TigranDesigner/Voron-Mods/DooMini/Photos/DooMini (6).jpg

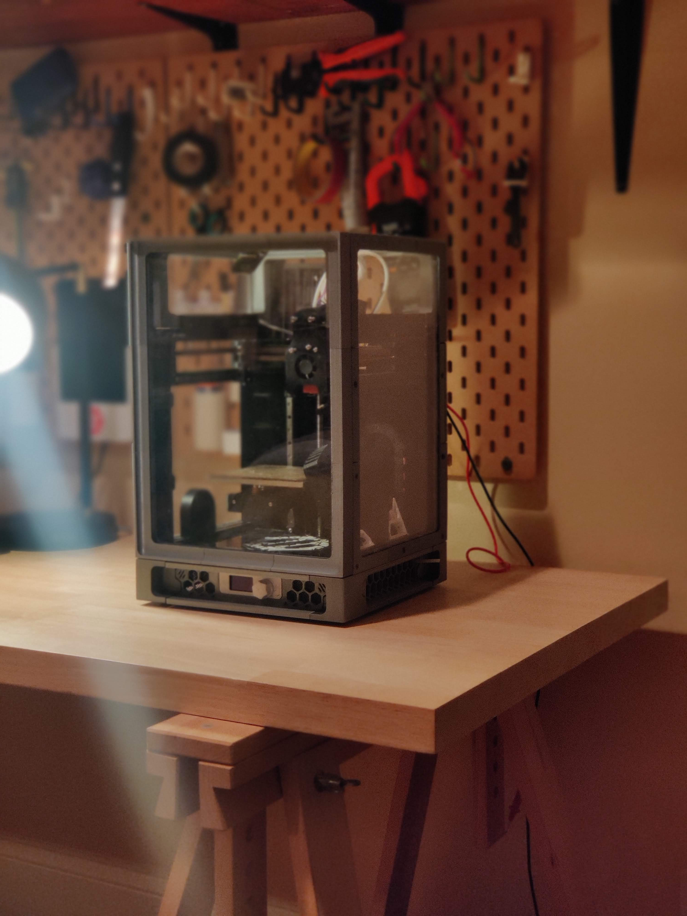
DooMini/Photos/DooMini (6).jpg
