TigranDesigner/Voron-Mods/DooMini/Photos/DooMini (1).jpg

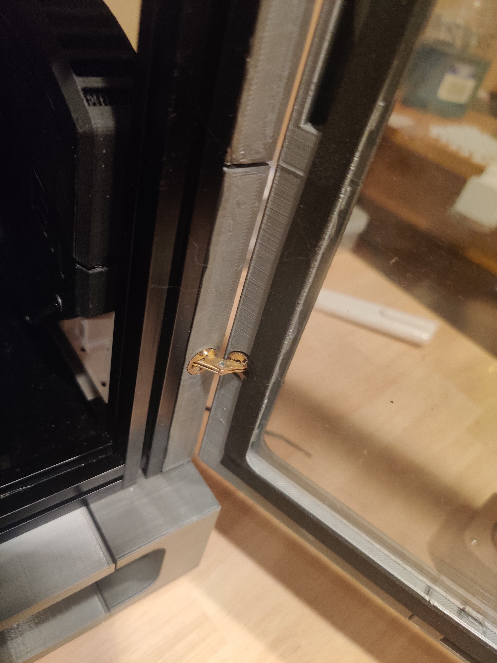
DooMini/Photos/DooMini (1).jpg
