TigranDesigner/Voron-Mods/README.md

# Voron-Mods
Voron 3D printer mods, remixes and designs. 
 
DooMini is here !!!
