TigranDesigner/Voron-Mods/DooMini Folding Spool Holder/README.md

<h1 align="center">Foldable Spool Honder For DooMini</h1>

  <p align="center">
    
| BOM  |       
| ------------- |
| 1x Heat set insert |
| 1x 16mm M3 flat head screw|
| 2x PTFE tube 85mm |
| 3D printed parts |
  
</p>

ViewCapture20220612_001325

ViewCapture20220612_001409
