TigranDesigner/Voron-Mods/DooMini Folding Spool Holder/Images/unknown (1).png

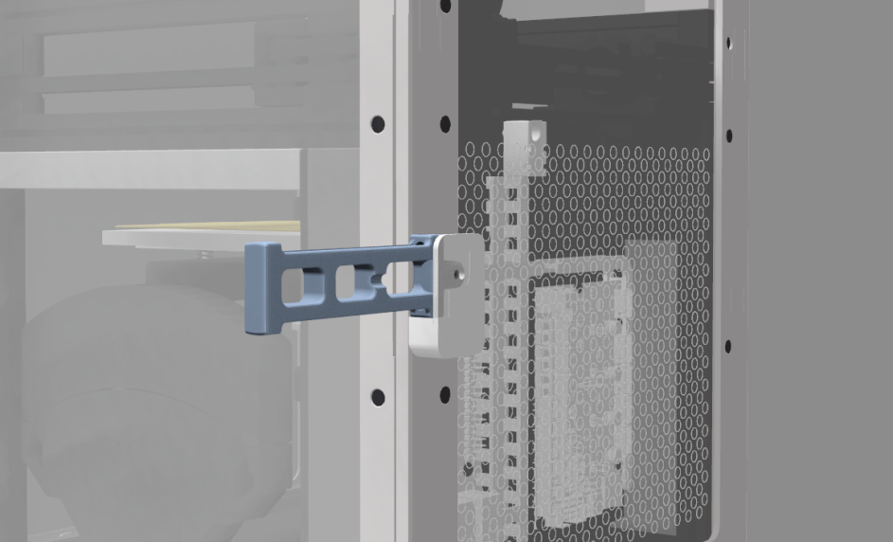
DooMini Folding Spool Holder/Images/unknown (1).png
