TigranDesigner/Voron-Mods/DooMini Folding Spool Holder/Images/unknown.png

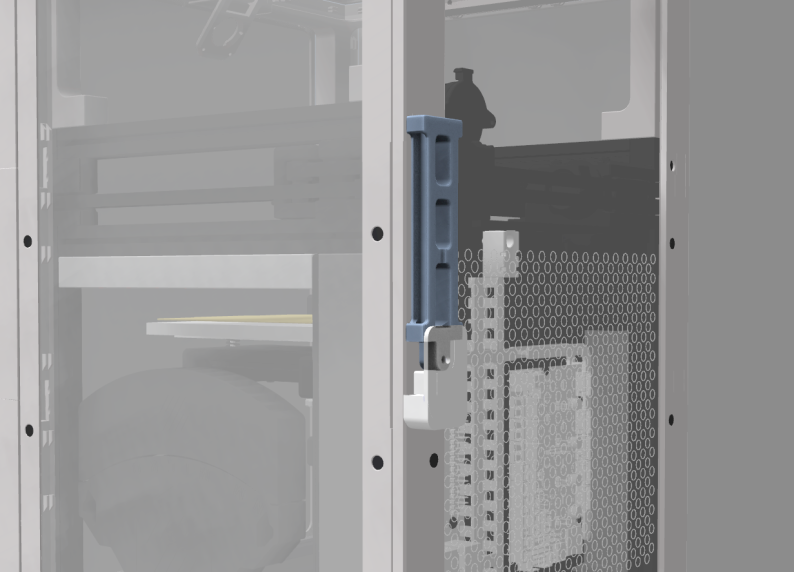
DooMini Folding Spool Holder/Images/unknown.png
