TigranDesigner/Voron-Mods/DooMini Folding Spool Holder/Images/ViewCapture20220612_001409.jpg

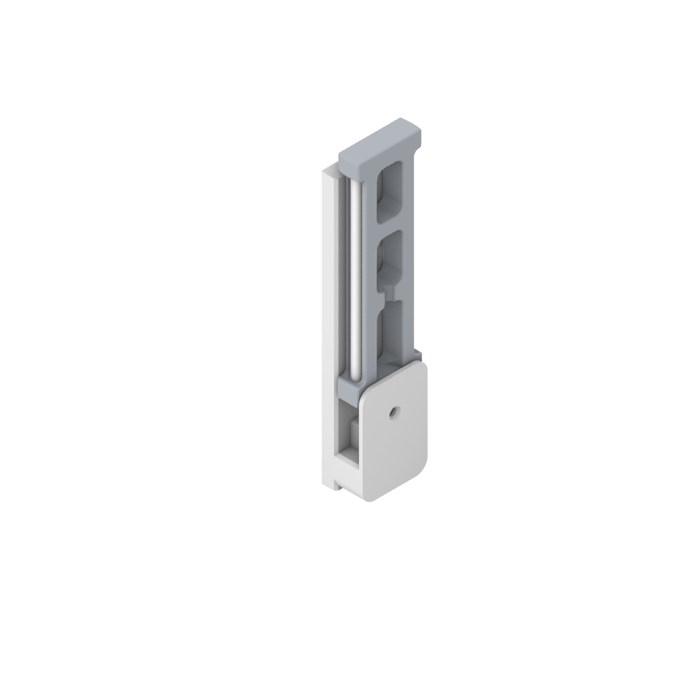
DooMini Folding Spool Holder/Images/ViewCapture20220612_001409.jpg
