TigranDesigner/Voron-Mods/DooMini/Photos/DooMini (5).jpg

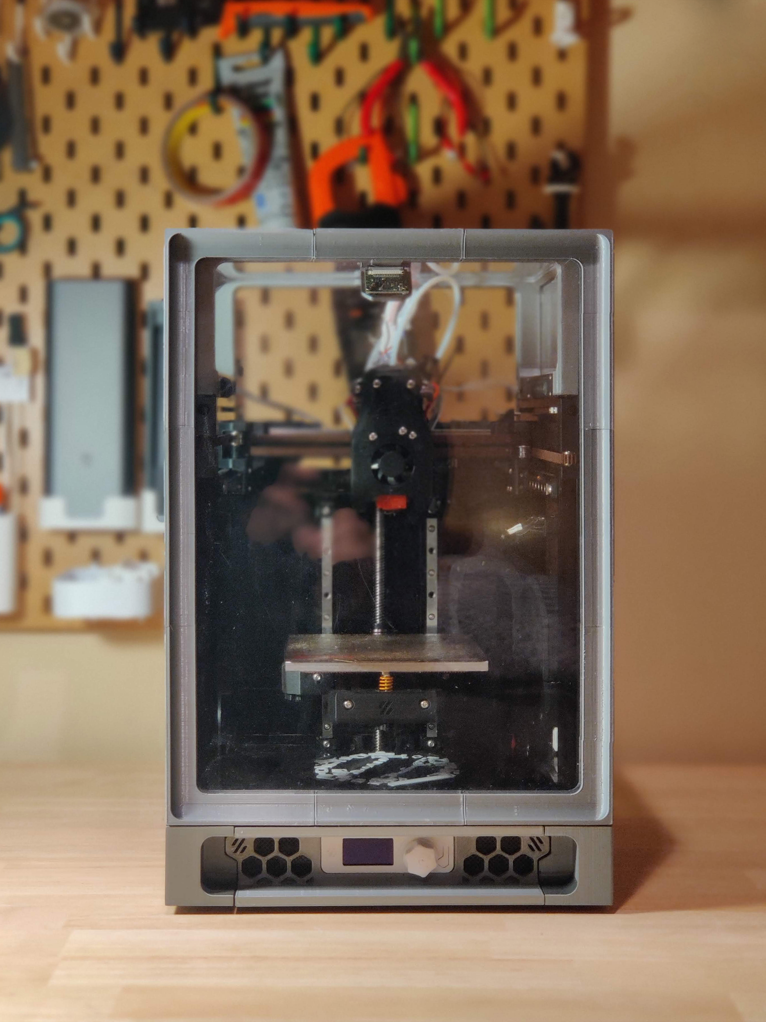
DooMini/Photos/DooMini (5).jpg
