TigranDesigner/Voron-Mods/DooMini/Photos/DooMini (7).jpg

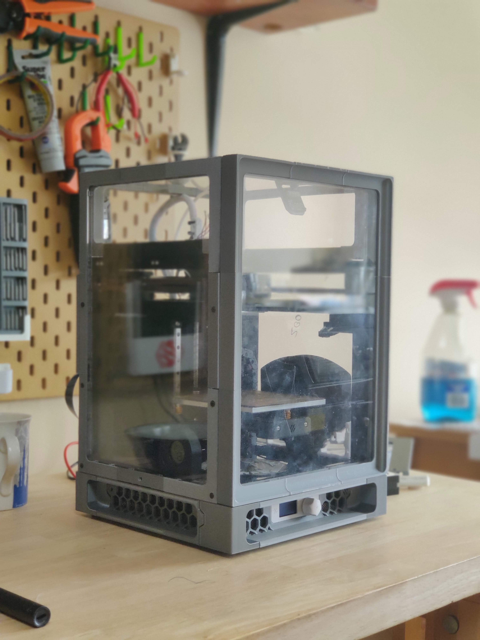
DooMini/Photos/DooMini (7).jpg
