TigranDesigner/Voron-Mods/DooMini Folding Spool Holder/STL/Hinge.stl

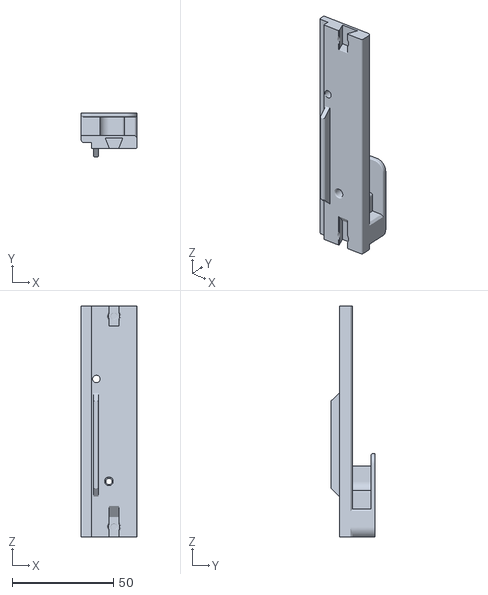
[picture p9: CAD file, 2022-06-12]
DooMini Folding Spool Holder/STL/Hinge.stl
27.5 x 21.9 x 114.3
