TigranDesigner/Voron-Mods/DooMini/DXFs/1X Back Panel Beta 2.dxf

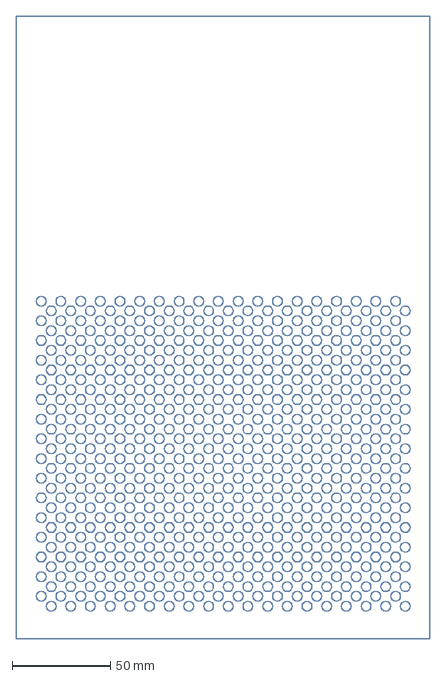
[picture p10: CAD file, 2022-03-14]
DooMini/DXFs/1X Back Panel Beta 2.dxf
210.0 x 316.0 mm
