TigranDesigner/Voron-Mods/DooMini/STLs/3D printed Interlock X28 Beta1.stl

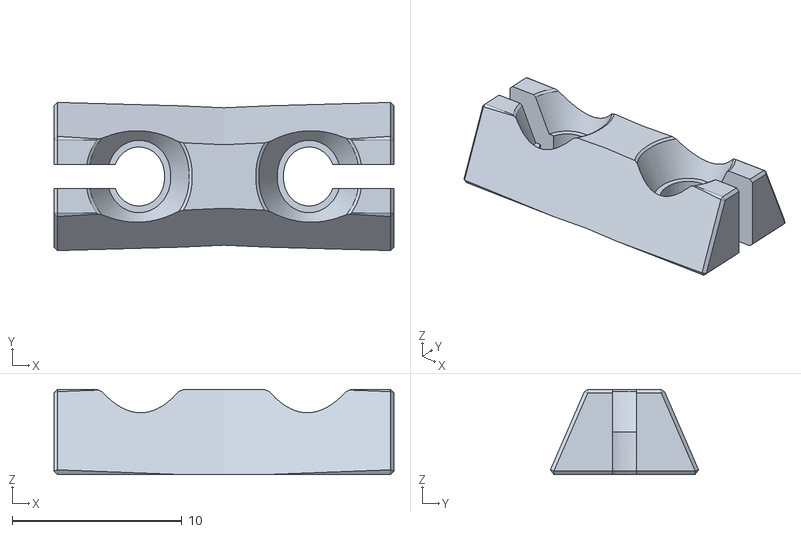
[picture p11: CAD file, 2022-02-13]
DooMini/STLs/3D printed Interlock X28 Beta1.stl
20.0 x 8.72 x 5.00
