TigranDesigner/Voron-Mods/DooMini/STLs/Back/Back H Beta1.stl

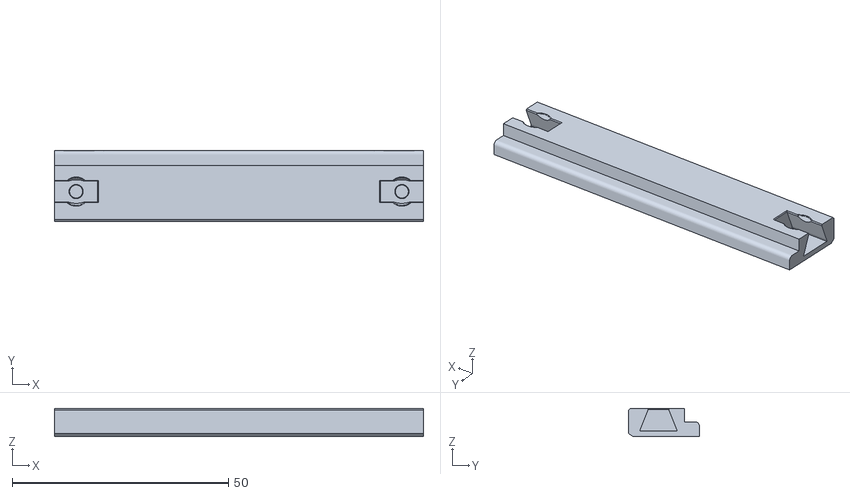
[picture p12: CAD file, 2022-02-14]
DooMini/STLs/Back/Back H Beta1.stl
85.3 x 16.4 x 6.50
