TigranDesigner/Voron-Mods/DooMini/STLs/Base/Base Panel Left Beta2.stl

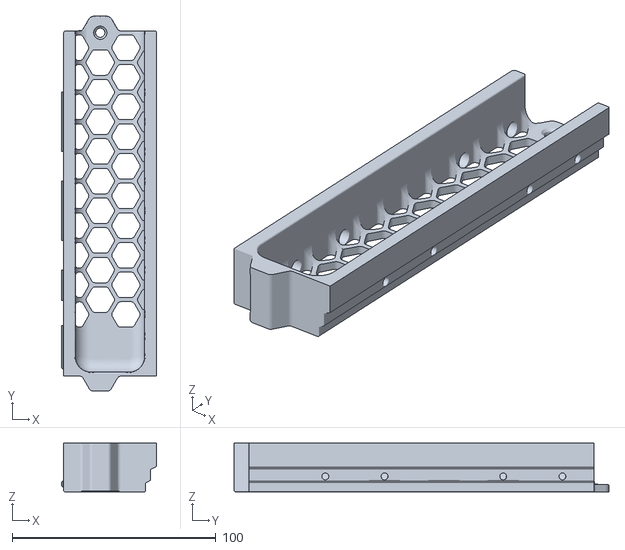
[picture p13: CAD file, 2022-06-12]
DooMini/STLs/Base/Base Panel Left Beta2.stl
46.5 x 183.9 x 23.8
