TigranDesigner/Voron-Mods/DooMini/STLs/Door/Door H Beta2.stl

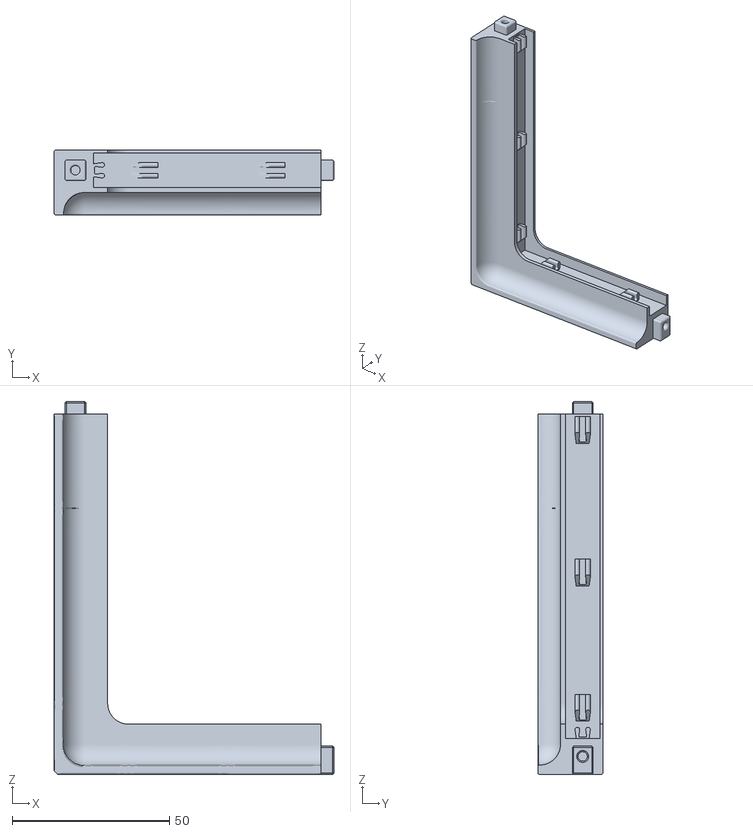
[picture p14: CAD file, 2022-08-16]
DooMini/STLs/Door/Door H Beta2.stl
88.8 x 20.8 x 118.5
