TigranDesigner/Voron-Mods/DooMini/STLs/Left/Left C Beta 2.stl

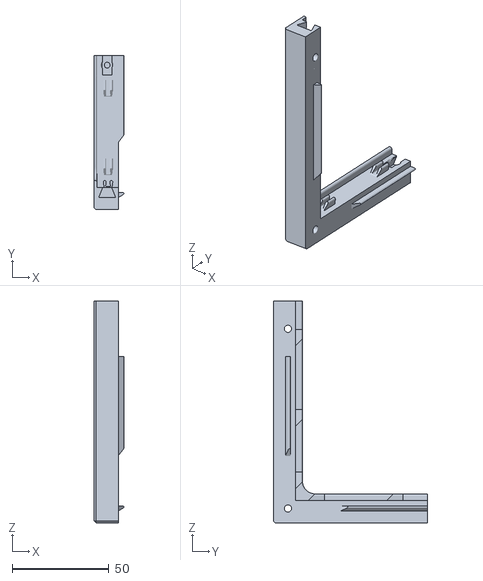
[picture p15: CAD file, 2022-03-18]
DooMini/STLs/Left/Left C Beta 2.stl
15.4 x 79.5 x 114.5
