TigranDesigner/Voron-Mods/DooMini/STLs/Top/Top G X2 Beta1.stl

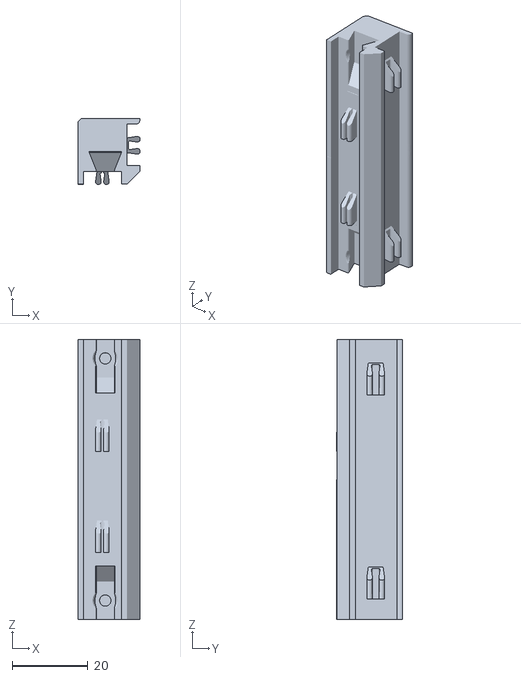
[picture p16: CAD file, 2022-02-14]
DooMini/STLs/Top/Top G X2 Beta1.stl
16.5 x 17.5 x 74.0
