TigranDesigner/Voron-Mods/DooMini/DXFs/4X Side Pane Beta1l.dxf

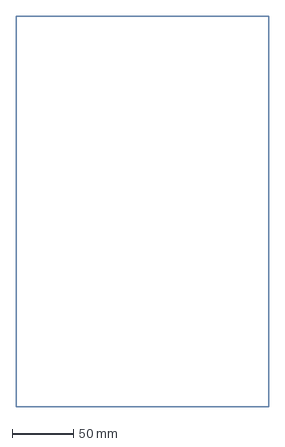
[picture p17: CAD file, 2022-02-14]
DooMini/DXFs/4X Side Pane Beta1l.dxf
206.0 x 318.0 mm
