TigranDesigner/Voron-Mods/DooMini/STLs/Back/Back G Beta1.stl

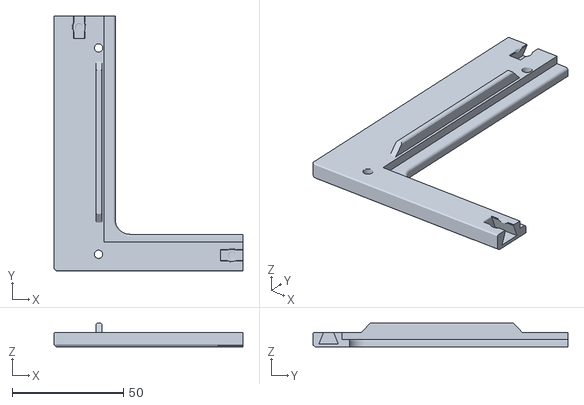
[picture p18: CAD file, 2022-02-14]
DooMini/STLs/Back/Back G Beta1.stl
84.8 x 114.5 x 10.7
