TigranDesigner/Voron-Mods/DooMini/STLs/Door/Door A Beta1.stl

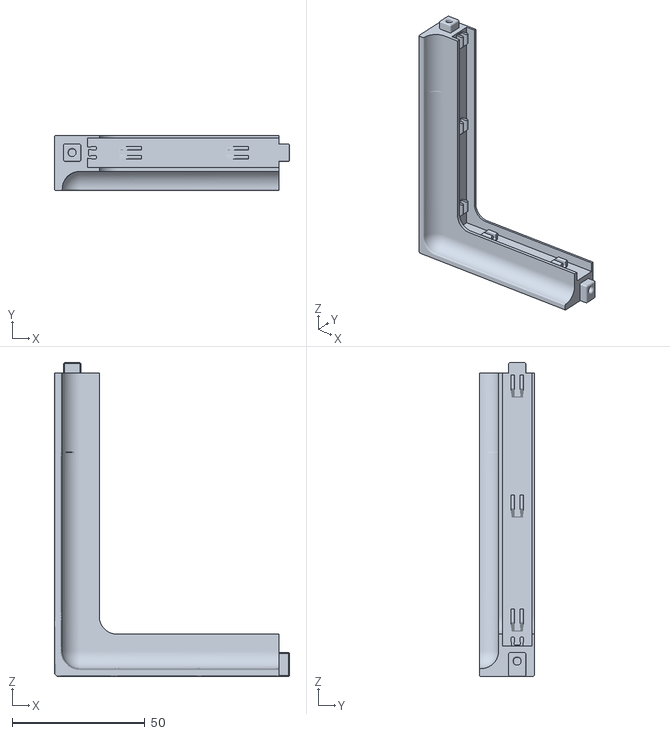
[picture p19: CAD file, 2022-04-15]
DooMini/STLs/Door/Door A Beta1.stl
88.8 x 20.8 x 118.5
