TigranDesigner/Voron-Mods/DooMini/STLs/Left/Left D Beta 2.stl

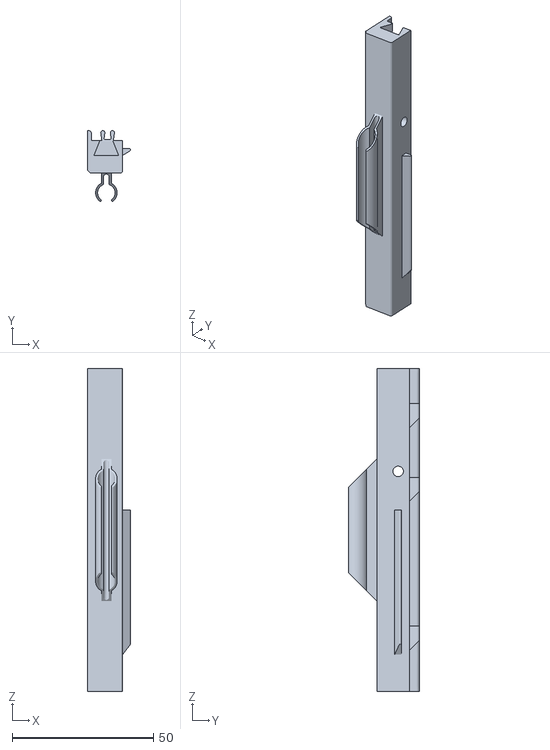
[picture p20: CAD file, 2022-03-18]
DooMini/STLs/Left/Left D Beta 2.stl
15.4 x 25.0 x 114.3
