TigranDesigner/Voron-Mods/DooMini/STLs/Right/Right E Beta 2.stl

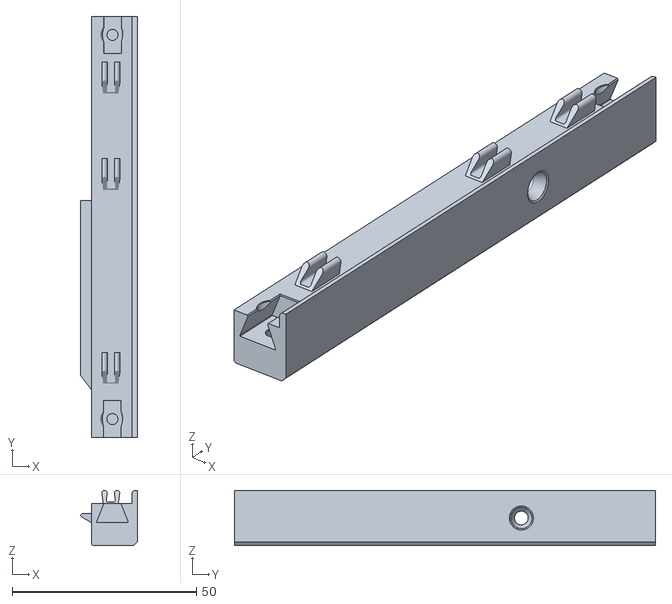
[picture p21: CAD file, 2022-03-18]
DooMini/STLs/Right/Right E Beta 2.stl
15.4 x 114.3 x 15.0
