TigranDesigner/Voron-Mods/DooMini/DXFs/2X Top Panel Beta1.dxf

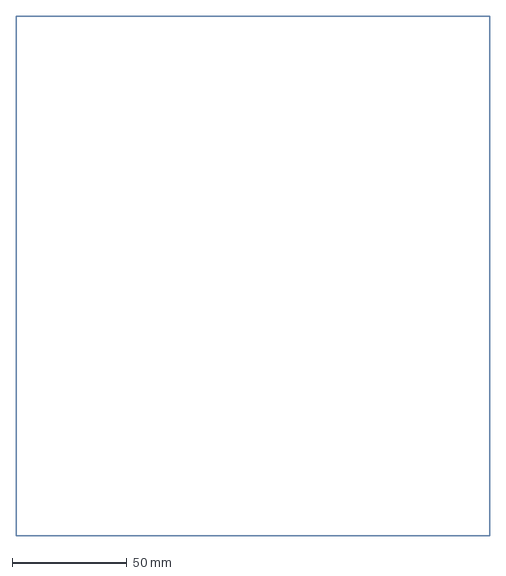
[picture p23: CAD file, 2022-02-14]
DooMini/DXFs/2X Top Panel Beta1.dxf
206.0 x 226.0 mm
