TigranDesigner/Voron-Mods/DooMini/STLs/Back/Back F Beta1.stl

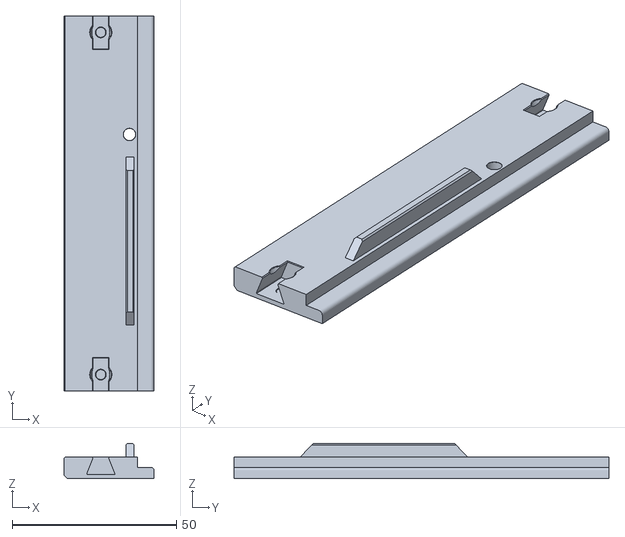
[picture p24: CAD file, 2022-02-14]
DooMini/STLs/Back/Back F Beta1.stl
27.5 x 114.3 x 10.7
