TigranDesigner/Voron-Mods/DooMini/STLs/Base/Base Panel Front Beta2.stl

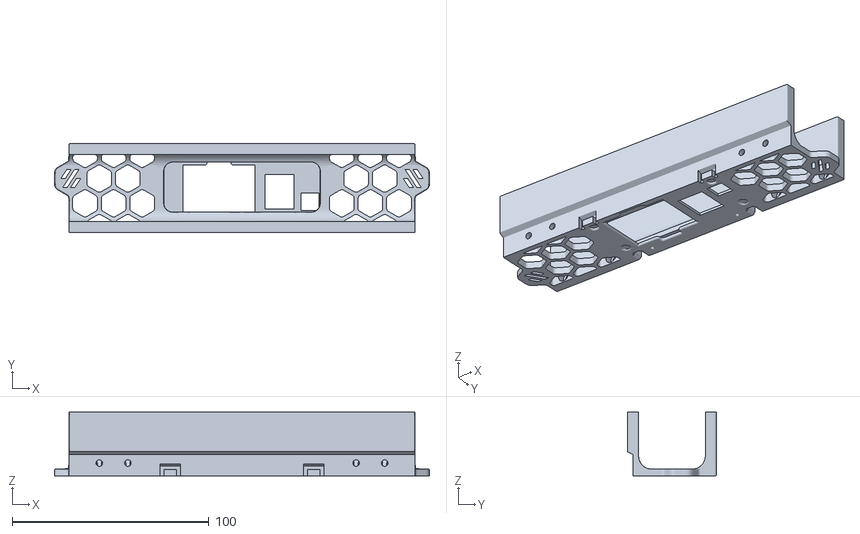
[picture p25: CAD file, 2022-06-10]
DooMini/STLs/Base/Base Panel Front Beta2.stl
190.8 x 45.5 x 32.5
