TigranDesigner/Voron-Mods/DooMini/STLs/Right/Right D Beta1.stl

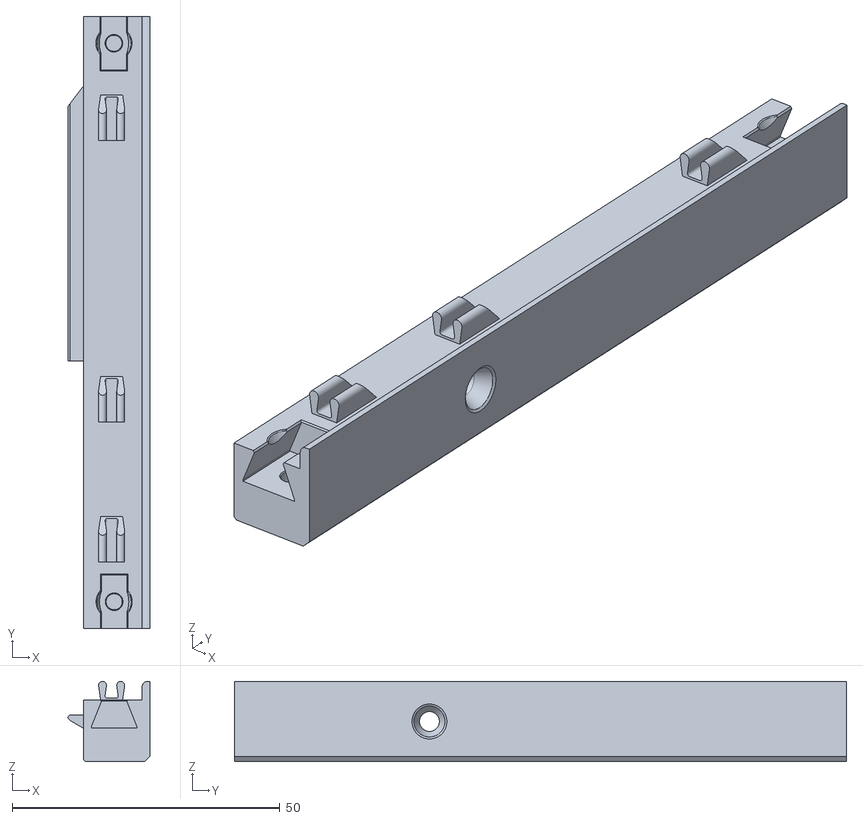
[picture p26: CAD file, 2022-02-14]
DooMini/STLs/Right/Right D Beta1.stl
15.4 x 114.3 x 15.0
