TigranDesigner/Voron-Mods/DooMini/DXFs/2X Door Panel Beta1.dxf

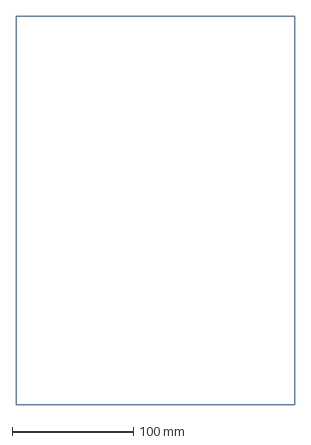
[picture p28: CAD file, 2022-02-14]
DooMini/DXFs/2X Door Panel Beta1.dxf
229.0 x 320.0 mm
