TigranDesigner/Voron-Mods/DooMini/STLs/Back/Back E Beta1.stl

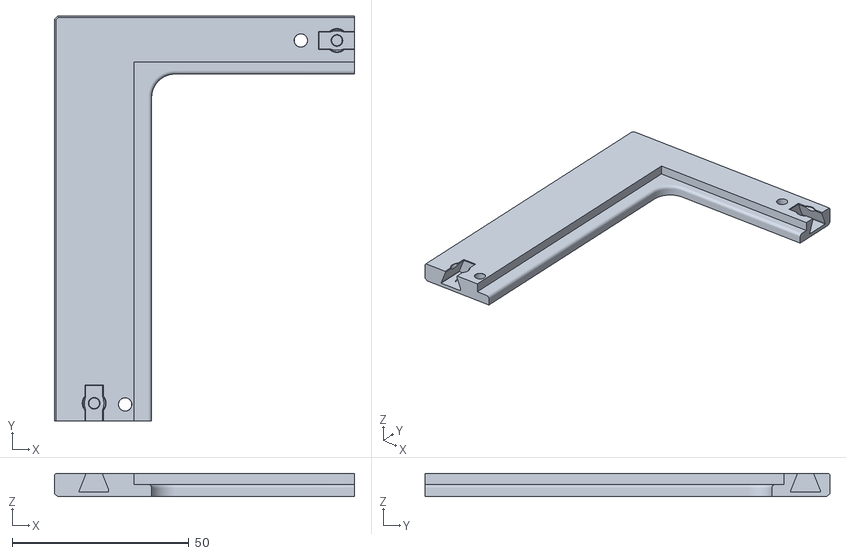
[picture p29: CAD file, 2022-02-14]
DooMini/STLs/Back/Back E Beta1.stl
84.8 x 114.4 x 6.50
