TigranDesigner/Voron-Mods/DooMini/STLs/Base/Base Panel Back Beta 4.stl

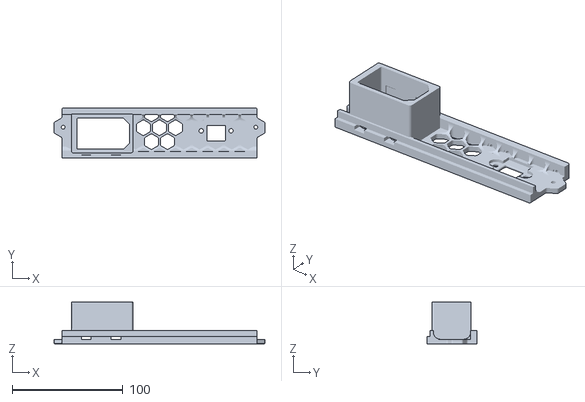
[picture p30: CAD file, 2022-03-06]
DooMini/STLs/Base/Base Panel Back Beta 4.stl
190.9 x 45.5 x 37.9
