TigranDesigner/Voron-Mods/DooMini/STLs/Door/Door G Beta1.stl

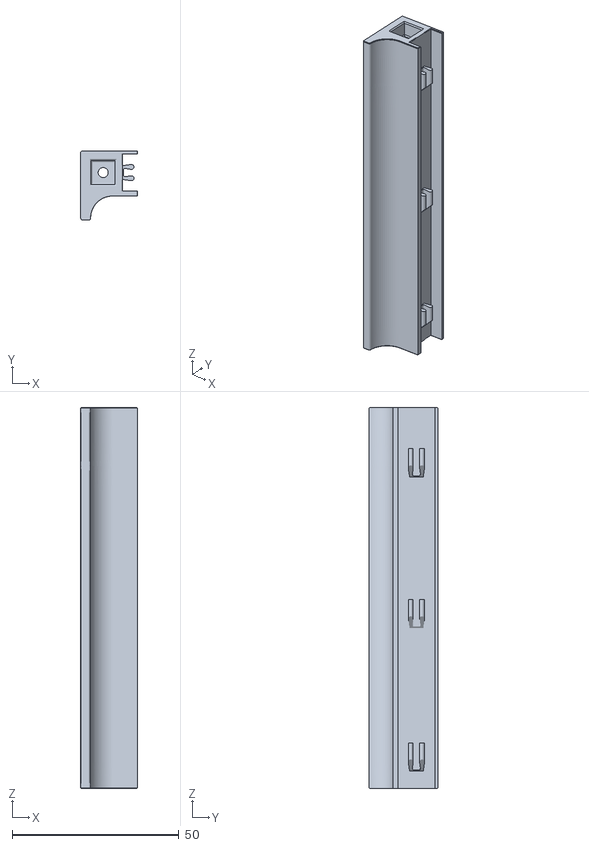
[picture p31: CAD file, 2022-02-14]
DooMini/STLs/Door/Door G Beta1.stl
17.0 x 20.8 x 114.3
