TigranDesigner/Voron-Mods/DooMini/STLs/Left/Left B Beta1.stl

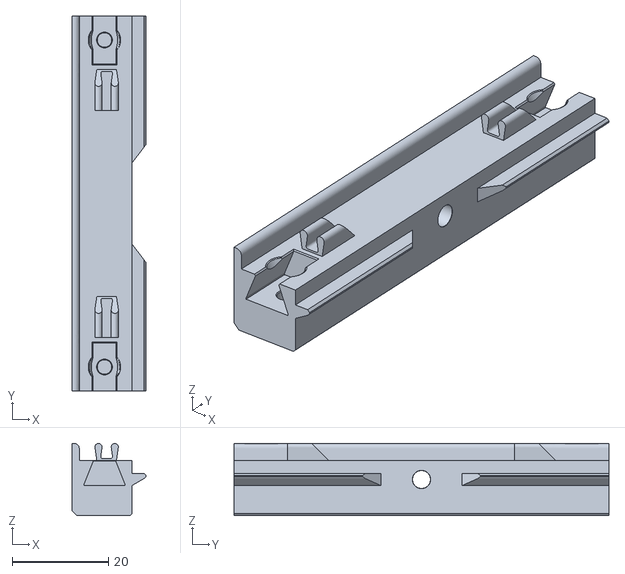
[picture p32: CAD file, 2022-02-14]
DooMini/STLs/Left/Left B Beta1.stl
15.4 x 78.1 x 15.0
