TigranDesigner/Voron-Mods/DooMini/STLs/Top/Top D Beta1.stl

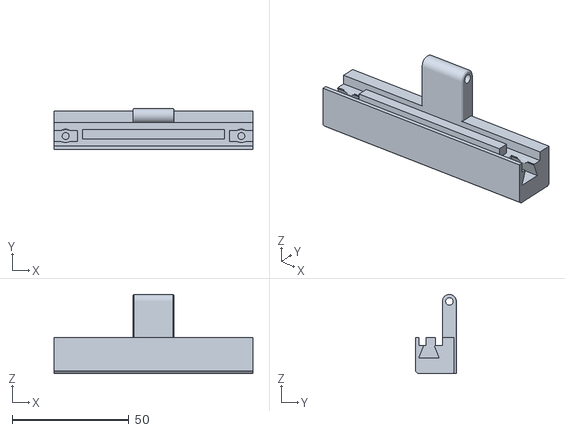
[picture p33: CAD file, 2022-02-14]
DooMini/STLs/Top/Top D Beta1.stl
85.3 x 17.5 x 33.9
