TigranDesigner/Voron-Mods/DooMini/DXFs/1X Base Panel Beta1.dxf

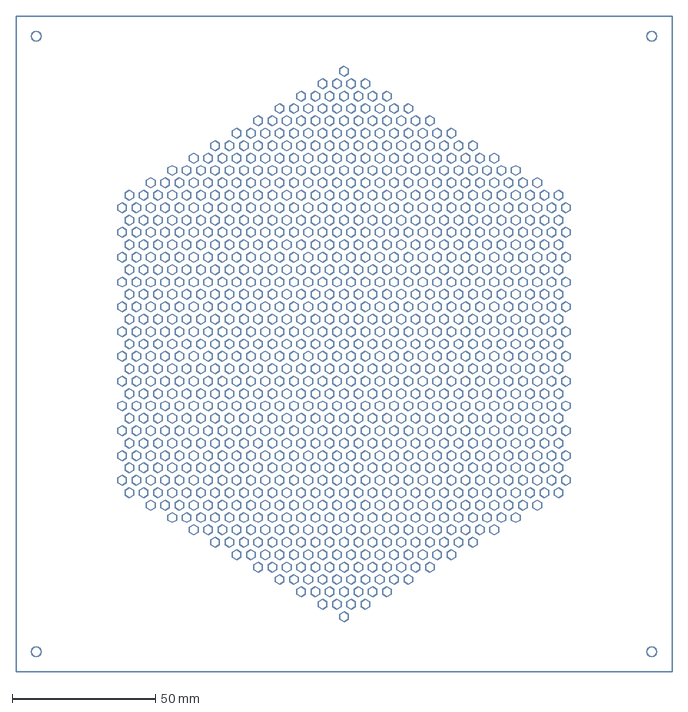
[picture p34: CAD file, 2022-02-14]
DooMini/DXFs/1X Base Panel Beta1.dxf
229.2 x 229.2 mm
