TigranDesigner/Voron-Mods/DooMini/STLs/Left/Left A Beta1.stl

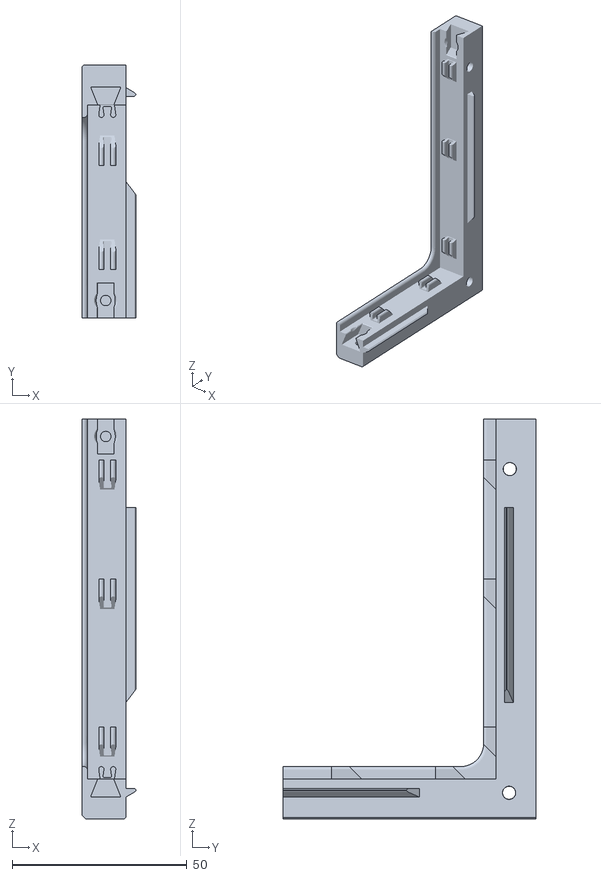
[picture p36: CAD file, 2022-02-14]
DooMini/STLs/Left/Left A Beta1.stl
15.4 x 72.4 x 114.5
