TigranDesigner/Voron-Mods/DooMini/STLs/Top/Top Camera Holder Beta1.stl

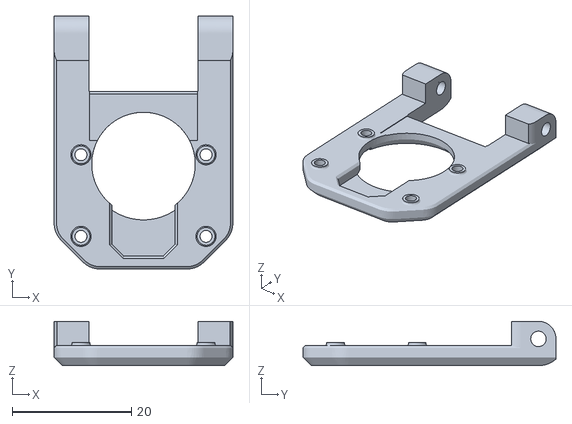
[picture p37: CAD file, 2022-02-14]
DooMini/STLs/Top/Top Camera Holder Beta1.stl
30.0 x 42.5 x 7.45
