TigranDesigner/Voron-Mods/DooMini/DXFs/1X Back Panel Beta1.dxf

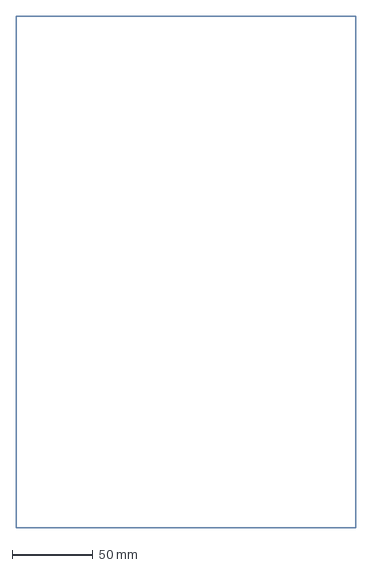
[picture p38: CAD file, 2022-02-14]
DooMini/DXFs/1X Back Panel Beta1.dxf
210.0 x 316.0 mm
