TigranDesigner/Voron-Mods/DooMini/STLs/Base/Base Panel Front Screen Front Headless Beta 1.stl

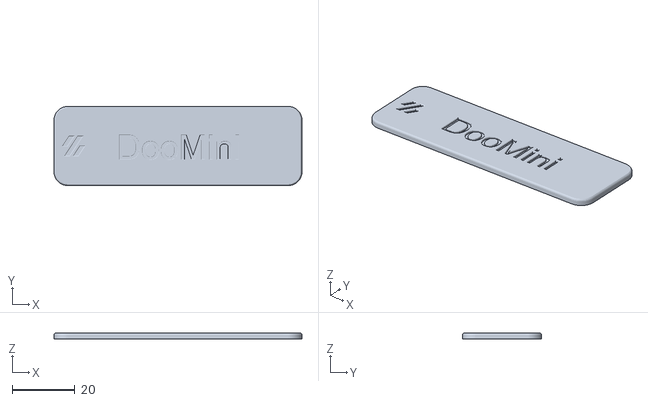
[picture p39: CAD file, 2022-03-06]
DooMini/STLs/Base/Base Panel Front Screen Front Headless Beta 1.stl
79.3 x 25.3 x 2.00
