TigranDesigner/Voron-Mods/DooMini/STLs/Top/Top C Beta1.stl

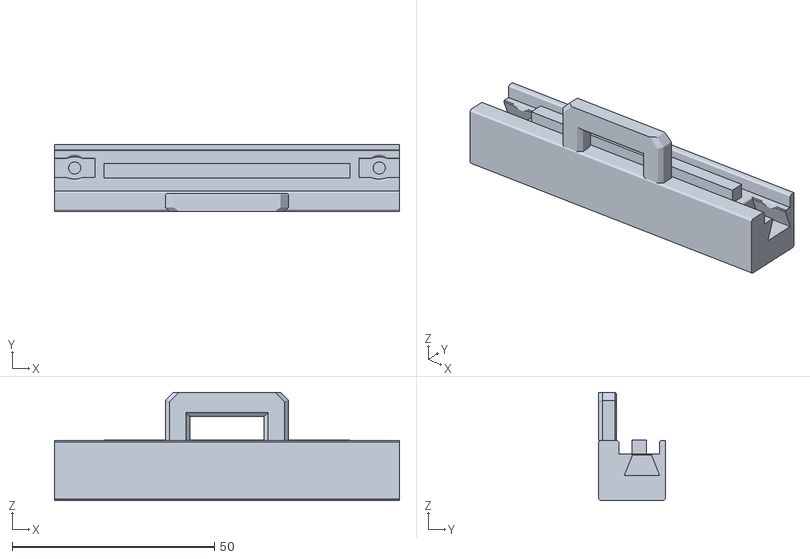
[picture p40: CAD file, 2022-02-14]
DooMini/STLs/Top/Top C Beta1.stl
85.3 x 16.5 x 26.8
