TigranDesigner/Voron-Mods/DooMini/STLs/Base/Base Panel Front Screen Front Beta 2 .stl

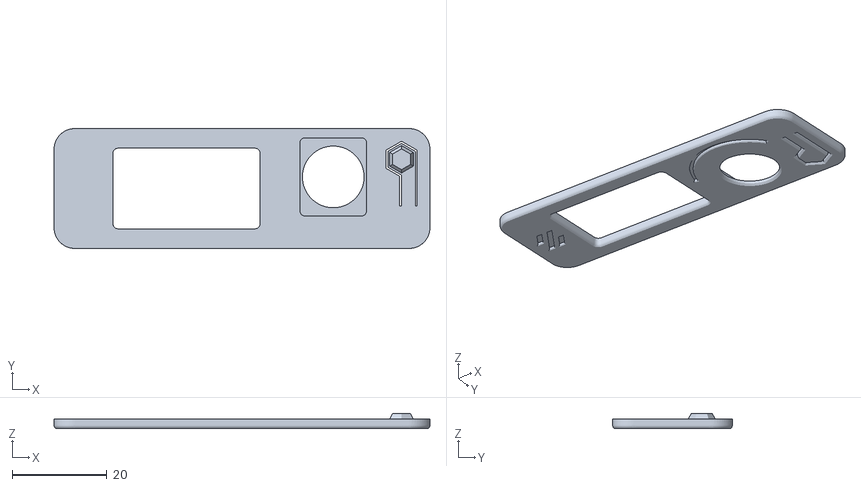
[picture p41: CAD file, 2022-03-01]
DooMini/STLs/Base/Base Panel Front Screen Front Beta 2 .stl
79.3 x 25.3 x 3.20
