TigranDesigner/Voron-Mods/DooMini/STLs/Door/Door C X2 Beta1.stl

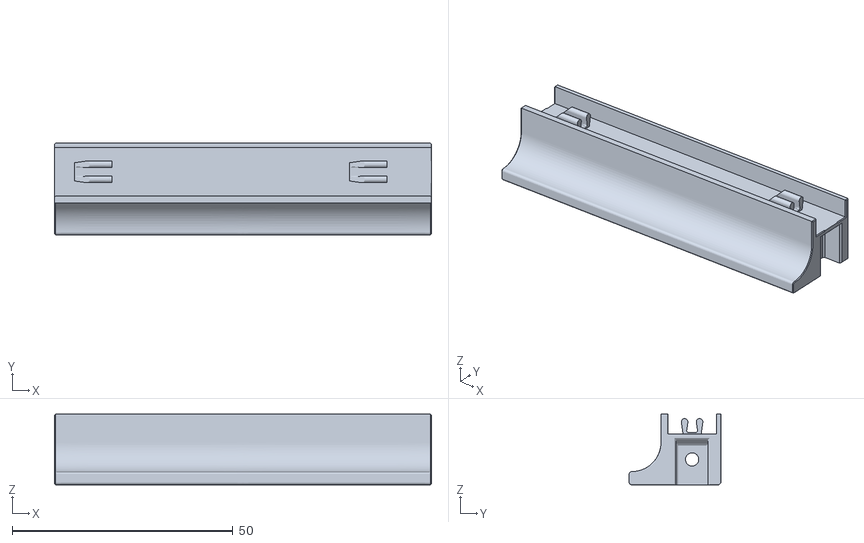
[picture p42: CAD file, 2022-02-14]
DooMini/STLs/Door/Door C X2 Beta1.stl
85.3 x 20.8 x 16.0
