TigranDesigner/Voron-Mods/DooMini/STLs/Top/Top B Beta1.stl

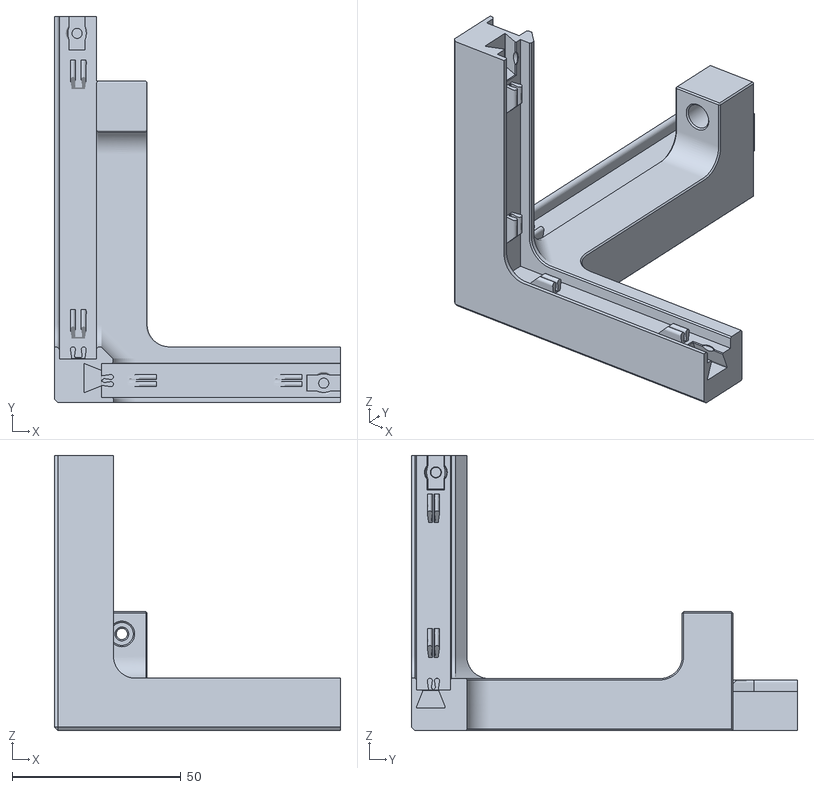
[picture p43: CAD file, 2022-02-14]
DooMini/STLs/Top/Top B Beta1.stl
84.8 x 114.4 x 81.5
