TigranDesigner/Voron-Mods/DooMini/STLs/Base/Base Leg Back L (Needs Support) Beta2.stl

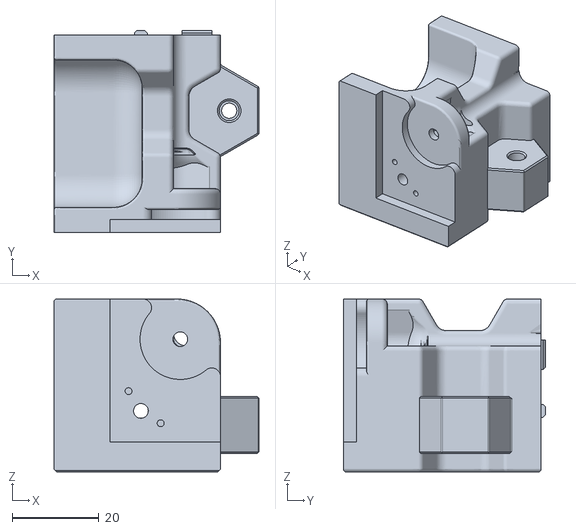
[picture p44: CAD file, 2022-02-20]
DooMini/STLs/Base/Base Leg Back L (Needs Support) Beta2.stl
47.2 x 46.5 x 39.8
