TigranDesigner/Voron-Mods/DooMini/STLs/Base/Base Panel Front Screen Spacer Beta1.stl

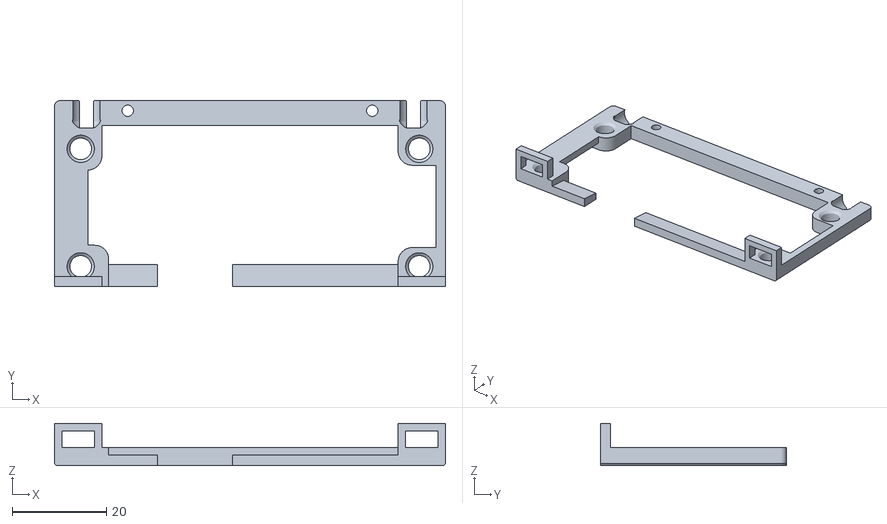
[picture p45: CAD file, 2022-02-14]
DooMini/STLs/Base/Base Panel Front Screen Spacer Beta1.stl
83.2 x 39.5 x 8.94
