TigranDesigner/Voron-Mods/DooMini/STLs/Base/Base Panel Front Knob Beta1.stl

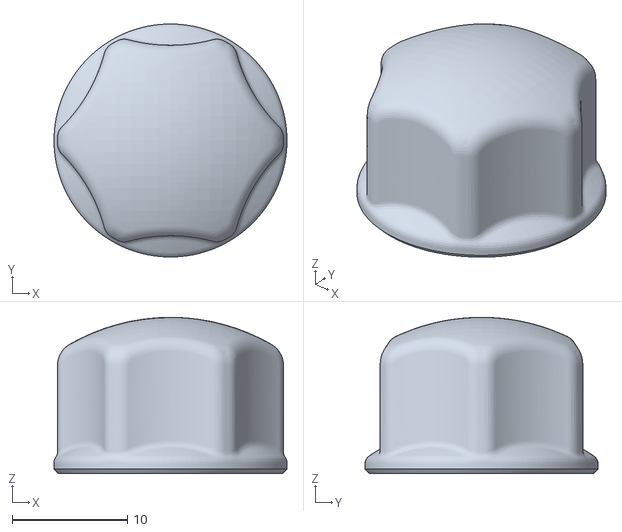
[picture p46: CAD file, 2022-02-14]
DooMini/STLs/Base/Base Panel Front Knob Beta1.stl
20.2 x 20.2 x 13.6
