TigranDesigner/Voron-Mods/DooMini/STLs/Base/Base Mesh Side B X2 Beta1.stl

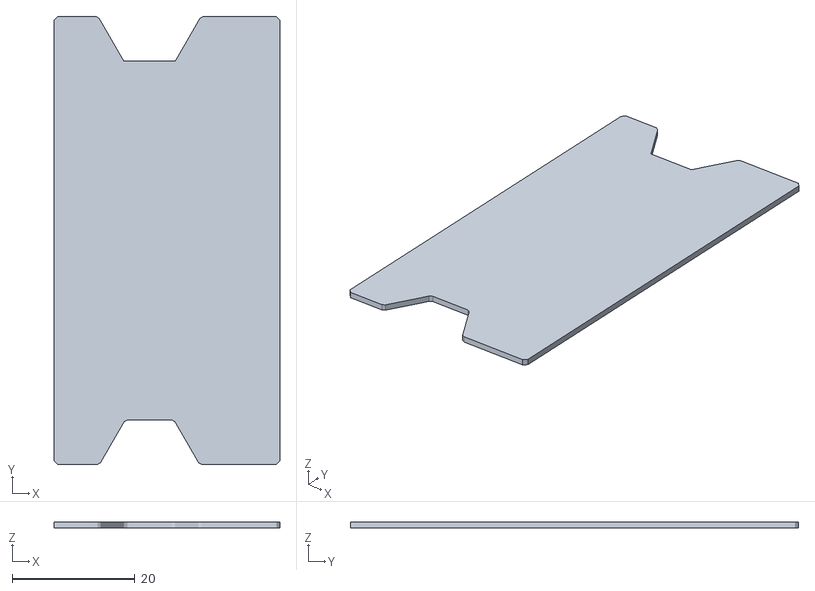
[picture p47: CAD file, 2022-02-14]
DooMini/STLs/Base/Base Mesh Side B X2 Beta1.stl
36.8 x 73.1 x 1.00
