TigranDesigner/Voron-Mods/DooMini/STLs/Base/Base Mesh Side A X2 Beta1.stl

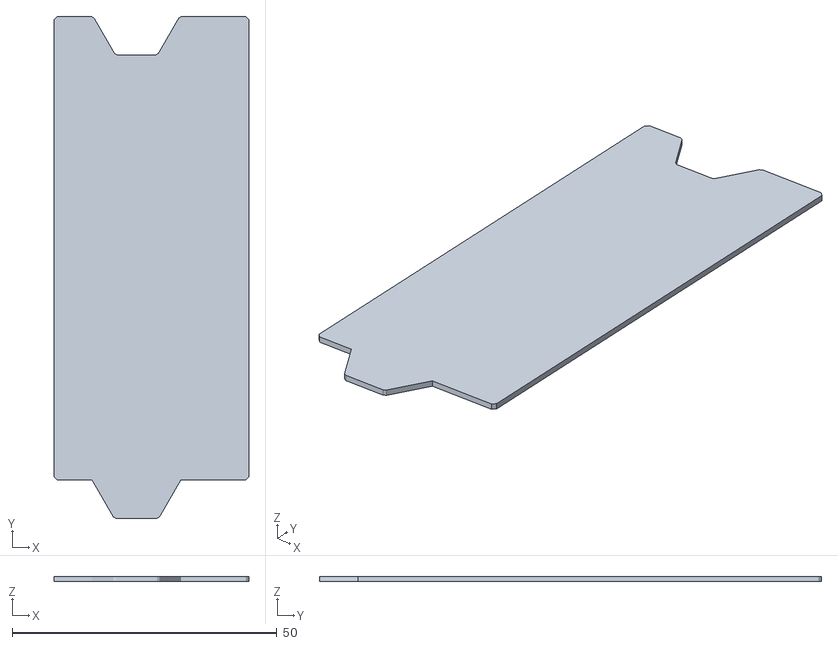
[picture p48: CAD file, 2022-02-14]
DooMini/STLs/Base/Base Mesh Side A X2 Beta1.stl
36.8 x 94.9 x 1.00
