TigranDesigner/Voron-Mods/DooMini/STLs/Base/Base Mesh Front X2 Beta1.stl

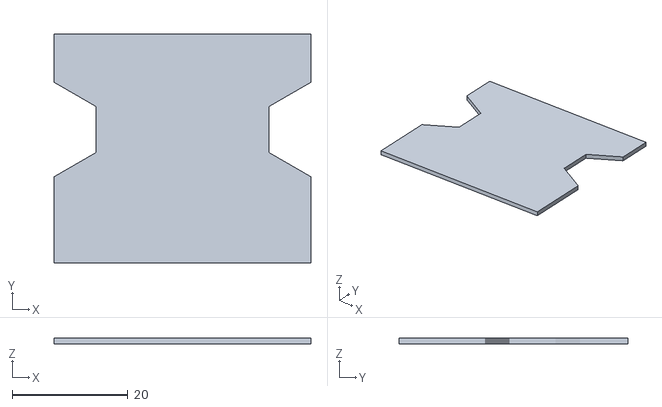
[picture p49: CAD file, 2022-02-14]
DooMini/STLs/Base/Base Mesh Front X2 Beta1.stl
44.4 x 39.5 x 1.00
