TigranDesigner/Voron-Mods/DooMini/STLs/Base/Base Leg Front R Beta1.stl

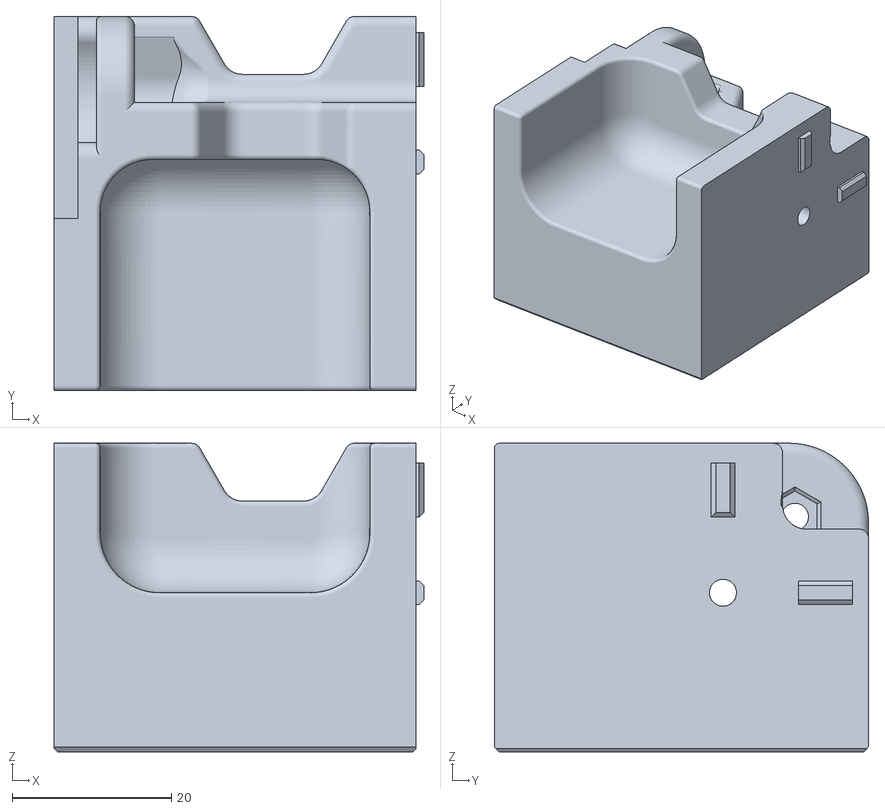
[picture p50: CAD file, 2022-02-14]
DooMini/STLs/Base/Base Leg Front R Beta1.stl
46.5 x 47.0 x 38.8
