TigranDesigner/Voron-Mods/(list of files, cad)

Other CAD files:
DooMini/STLs/Right/Right C Beta 2.stl
DooMini/STLs/Base/Base Panel Right Beta2.stl
DooMini/STLs/Door/Door B Beta2.stl
DooMini/STLs/Left/Left E Beta 2.stl
DooMini/STLs/Right/Right B Beta1.stl
DooMini/STLs/Back/Back D Beta1.stl
DooMini/STLs/Door/Door F Beta1.stl
DooMini/STLs/Right/Right A Beta1.stl
DooMini/STLs/Back/Back C Beta1.stl
DooMini/STLs/Door/Door E Beta1.stl
DooMini/STLs/Back/Back B Beta1.stl
DooMini/STLs/Back/Back A Beta1.stl
DooMini/STLs/Top/Top A Beta1.stl
DooMini/STLs/Base/Base Leg Back R (Needs Support) Beta2.stl
DooMini/STLs/Base/Base Leg Front L Beta1.stl
