TigranDesigner/Voron-Mods/DooMini/Manual/DooMini Manual Beta1.pdf

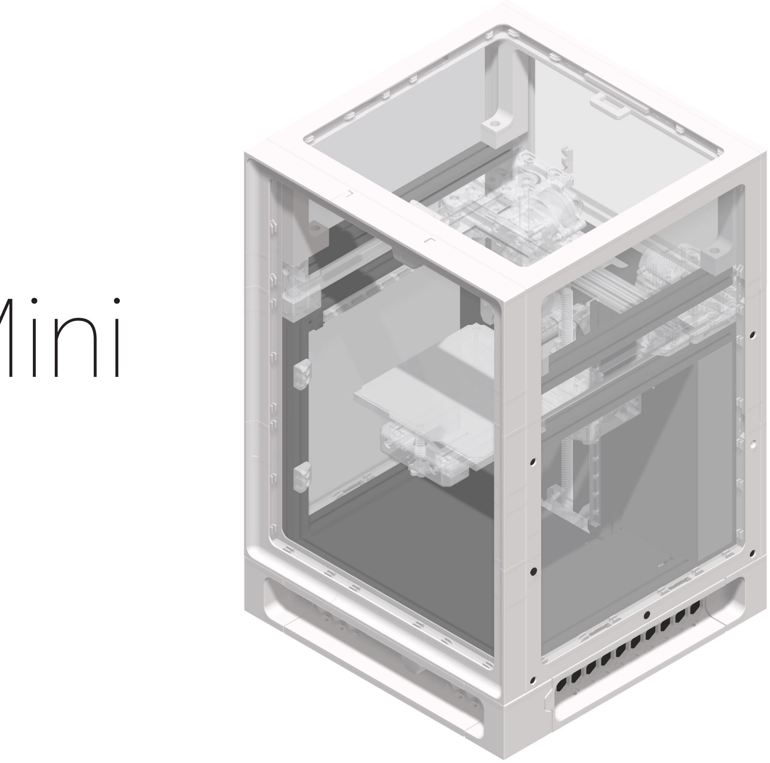
[picture p51: figure]

DooMini Voron 0.1 Mod By Tigran Kostandyan | 1

# DooMini

# Assembly Manual

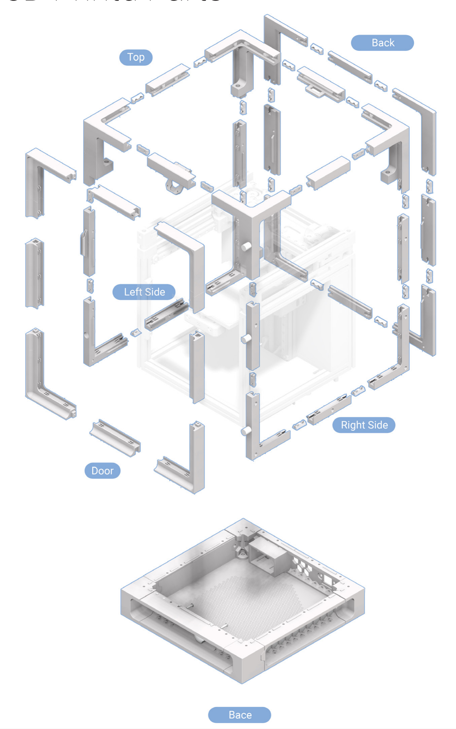
[picture p52: figure]
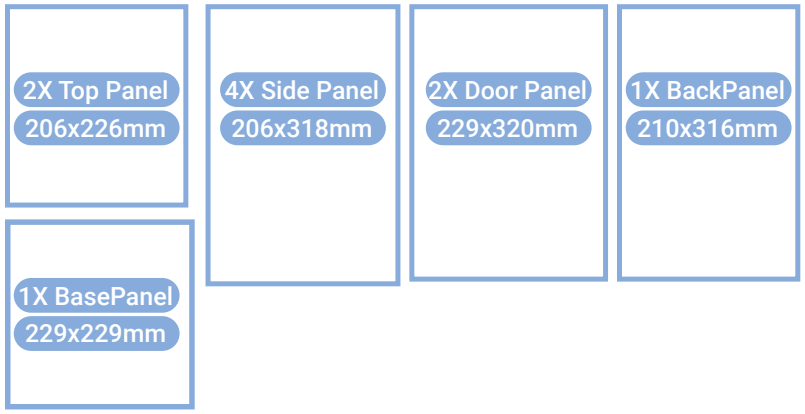
[picture p53: figure]
2X Top Panel 206x226mm; 1X BasePanel 229x229mm; 4X Side Panel 206x318mm; 2X Door Panel 229x320mm; 1X BackPanel 210x316mm
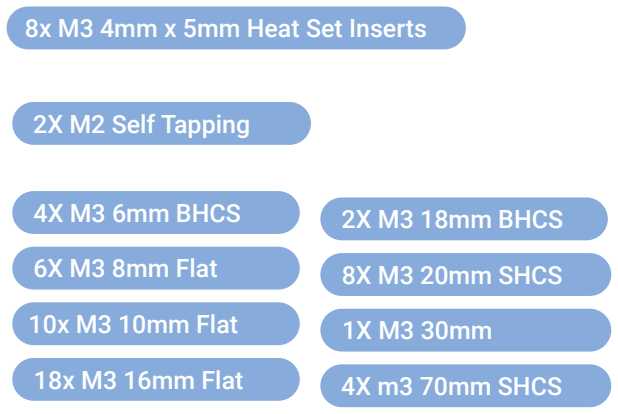
[picture p54: figure]
8x M3 4mm x 5mm Heat Set Inserts; 2X M2 Self Tapping; 4X M3 6mm BHCS; 2X M3 18mm BHCS; 4X m3 70mm SHCS; 6X M3 8mm Flat; 8X M3 20mm SHCS; 18x M3 16mm Flat; 10x M3 10mm Flat

DooMini Voron 0.1 Mod By Tigran Kostandyan | 2

### 3x 10mm Hidden Brass Barrel Hinges

Acrylic Panels 3mm | 3D Printd Parts

# Hardware

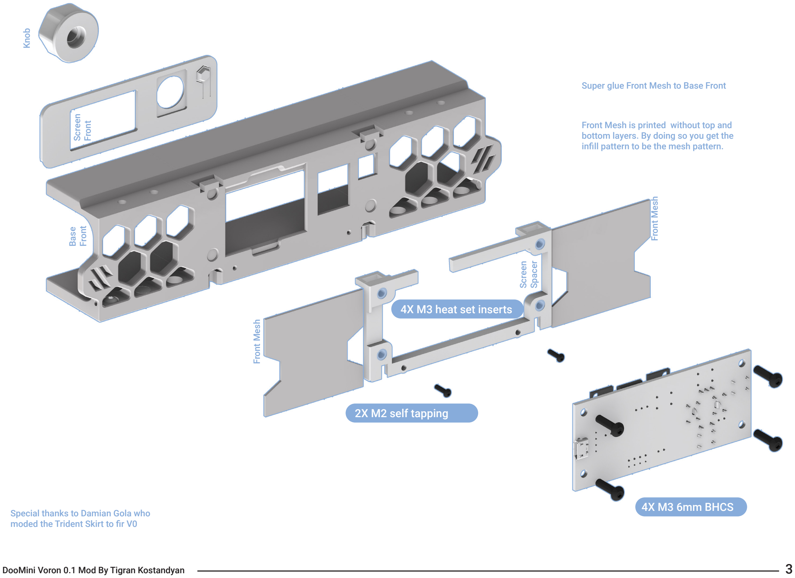
[picture p55: page 3]

DooMini Voron 0.1 Mod By Tigran Kostandyan | 3

### 4X M3 6mm BHCS

### 4X M3 heat set inserts

### 2X M2 self tapping

Front Mesh

Front Mesh

Front Mesh is printed without top and bottom layers. By doing so you get the infill pattern to be the mesh pattern.

Super glue Front Mesh to Base Front

Special thanks to Damian Gola who moded the Trident Skirt to fir V0

Screen

Spacer

Base

# Front Screen Front

Knob

### M3 18mm BHCS

### M3 18mm BHCS

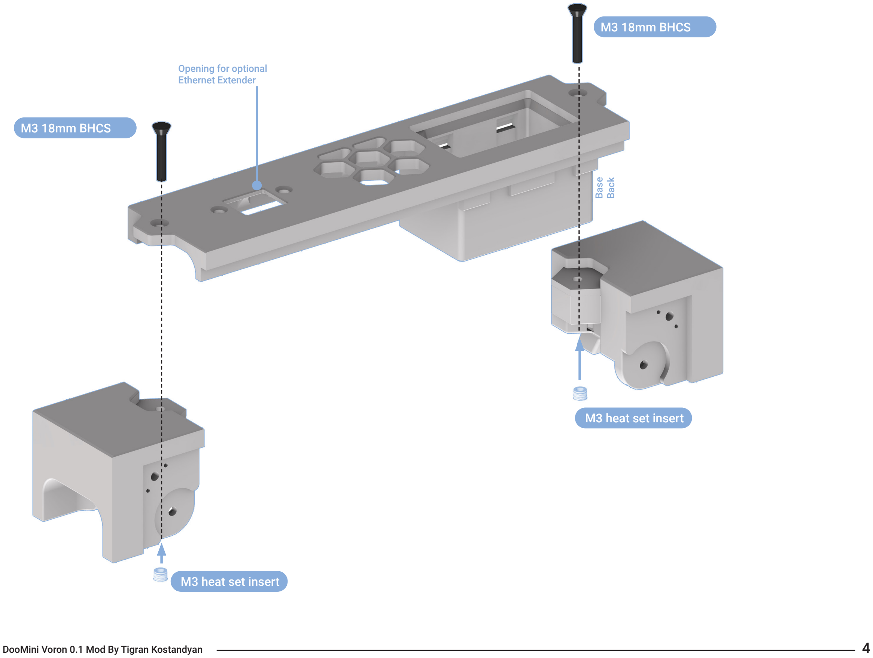
[picture p56: page 4]

DooMini Voron 0.1 Mod By Tigran Kostandyan | 4

Opening for optional
Ethernet Extender

Base
Back

### M3 heat set insert

### M3 heat set insert

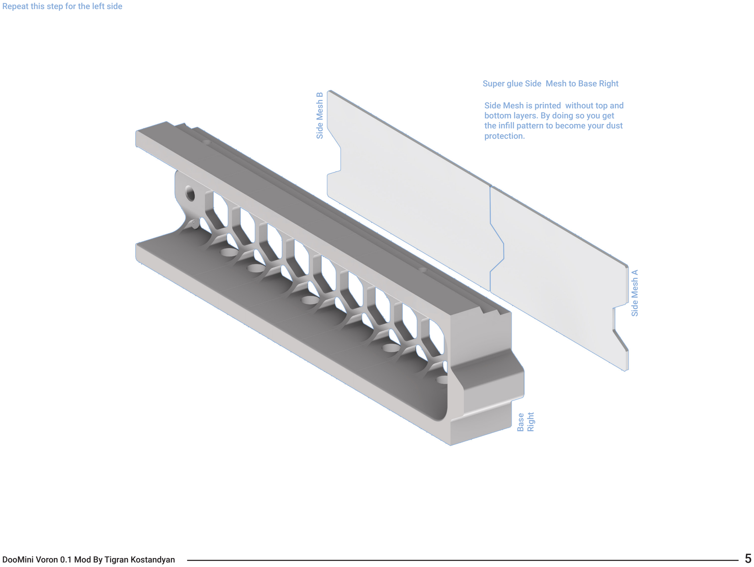
[picture p57: page 5]

DooMini Voron 0.1 Mod By Tigran Kostandyan | 5 Base Right

Side Mesh is printed without top and bottom layers. By doing so you get the infill pattern to become your dust protection.

Repeat this step for the left side

Side Mesh A

Side Mesh B

Super glue Side Mesh to Base Right

### 4X m3 x 70mm SHCS

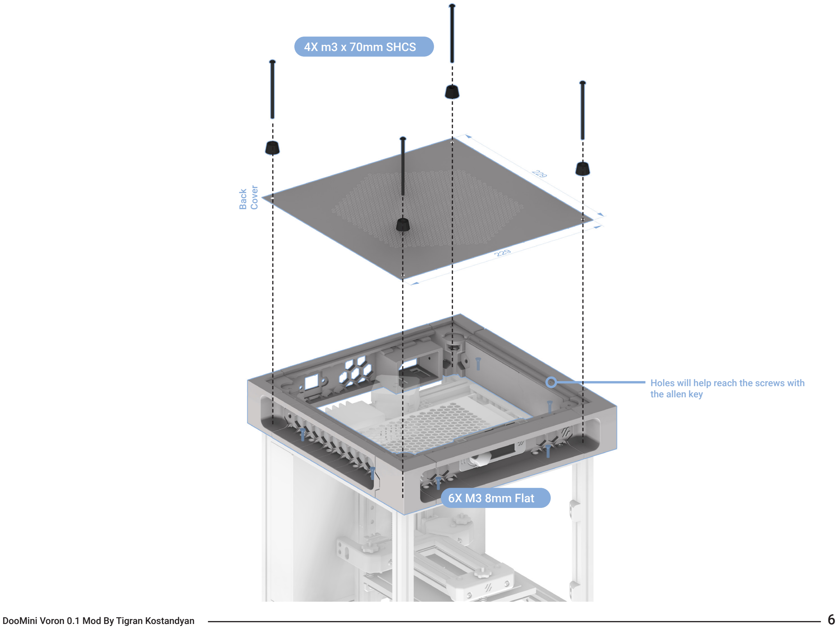
[picture p58: page 6]

DooMini Voron 0.1 Mod By Tigran Kostandyan | 6

### 6X M3 8mm Flat

Back

Cover

Holes will help reach the screws with the allen key

### M3 x 20mm SHCS

G

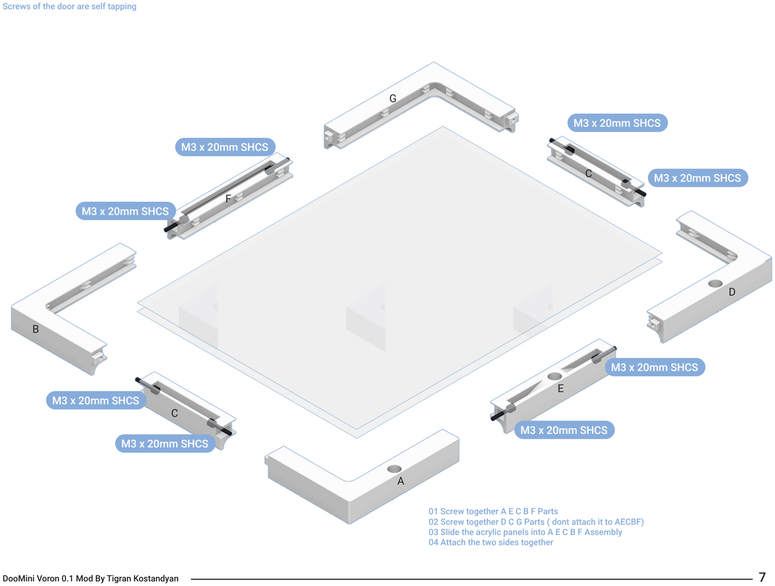
[picture p59: page 7]

DooMini Voron 0.1 Mod By Tigran Kostandyan | 7

### M3 x 20mm SHCS

### M3 x 20mm SHCS

### M3 x 20mm SHCS

### M3 x 20mm SHCS

### M3 x 20mm SHCS

### M3 x 20mm SHCS

### M3 x 20mm SHCS

Screws of the door are self tapping

### 01 Screw together A E C B F Parts 02 Screw together D C G Parts ( dont attach it to AECBF) 03 Slide the acrylic panels into A E C B F Assembly 04 Attach the two sides together

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
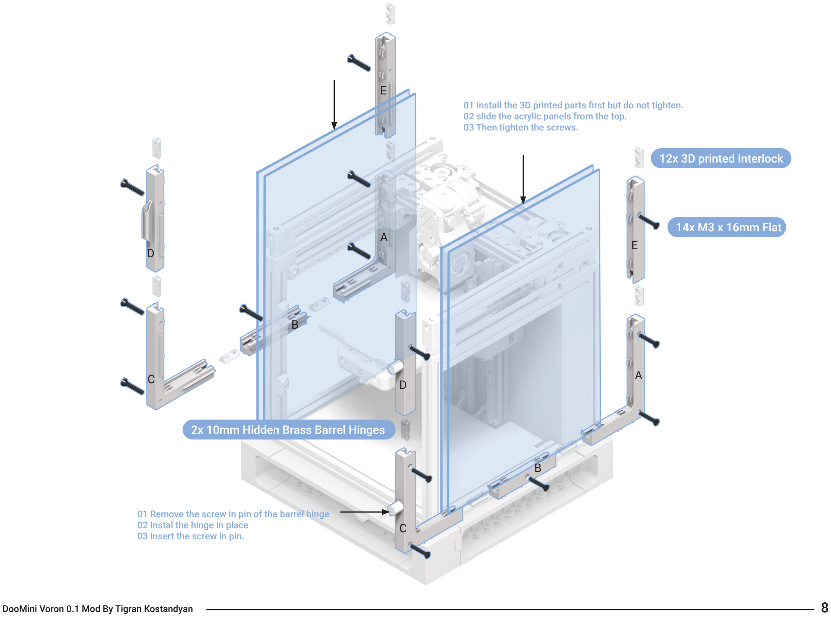
[picture p60: page 8]

DooMini Voron 0.1 Mod By Tigran Kostandyan | 8

### 14x M3 x 16mm Flat

### 2x 10mm Hidden Brass Barrel Hinges

### 12x 3D printed Interlock

01 install the 3D printed parts first but do not tighten. 02 slide the acrylic panels from the top.
03 Then tighten the screws.

### 01 Remove the screw in pin of the barrel hinge 02 Instal the hinge in place

03 Insert the screw in pin.

A

A

B

B

C

C | D
D | E

A

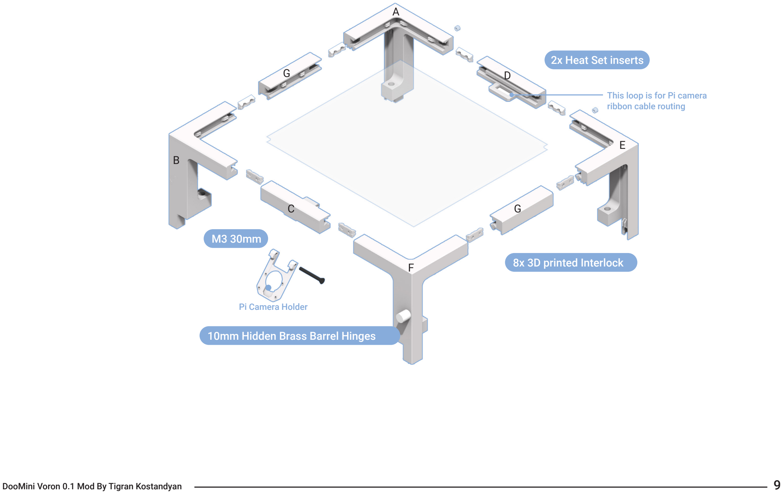
[picture p61: page 9]

DooMini Voron 0.1 Mod By Tigran Kostandyan | 9

### 10mm Hidden Brass Barrel Hinges

### M3 30mm

### 8x 3D printed Interlock

### 2x Heat Set inserts

Pi Camera Holder

This loop is for Pi camera ribbon cable routing

B

C

D

E

F

G

G

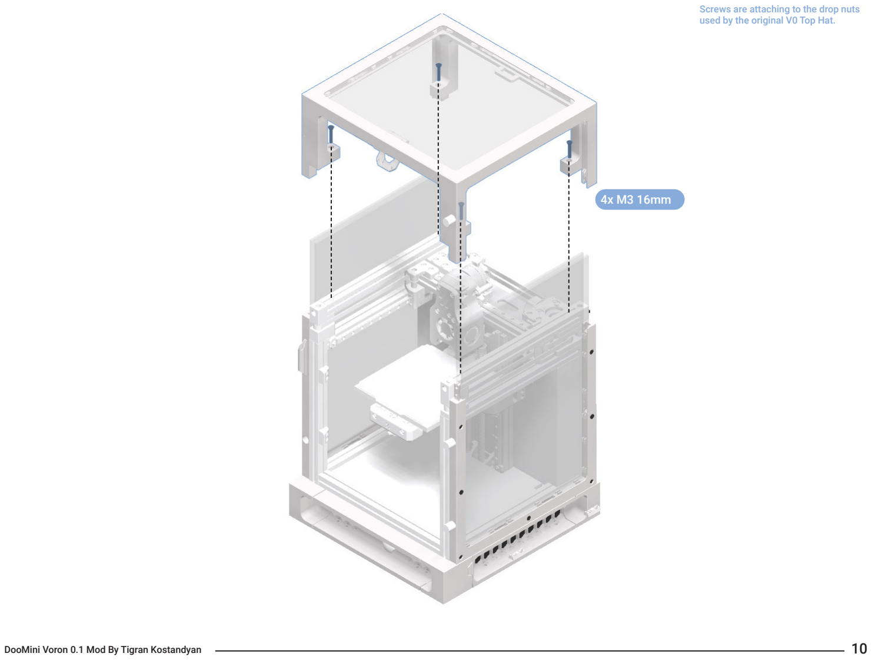
[picture p62: page 10]

DooMini Voron 0.1 Mod By Tigran Kostandyan | 10

### 4x M3 16mm

Screws are attaching to the drop nuts used by the original V0 Top Hat.

### 8x 3D printed Interlock

D

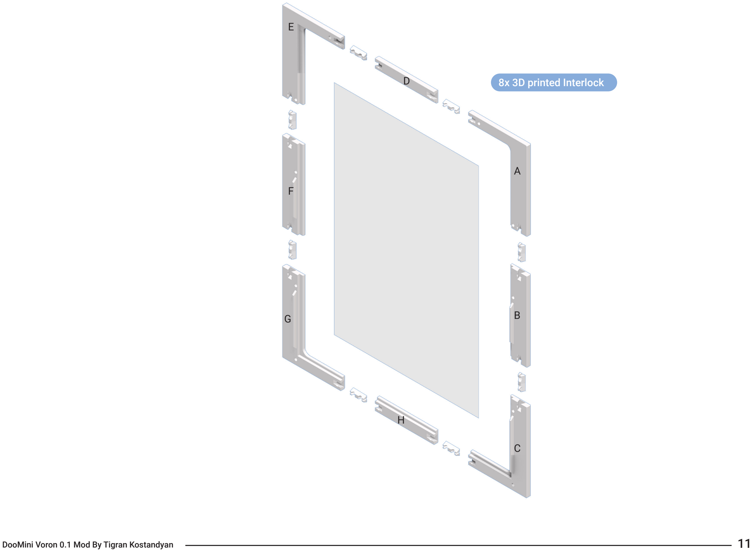
[picture p63: page 11]

DooMini Voron 0.1 Mod By Tigran Kostandyan | 11

A

B

C

E

F

G

H

## Show the Buttom Than top Conection

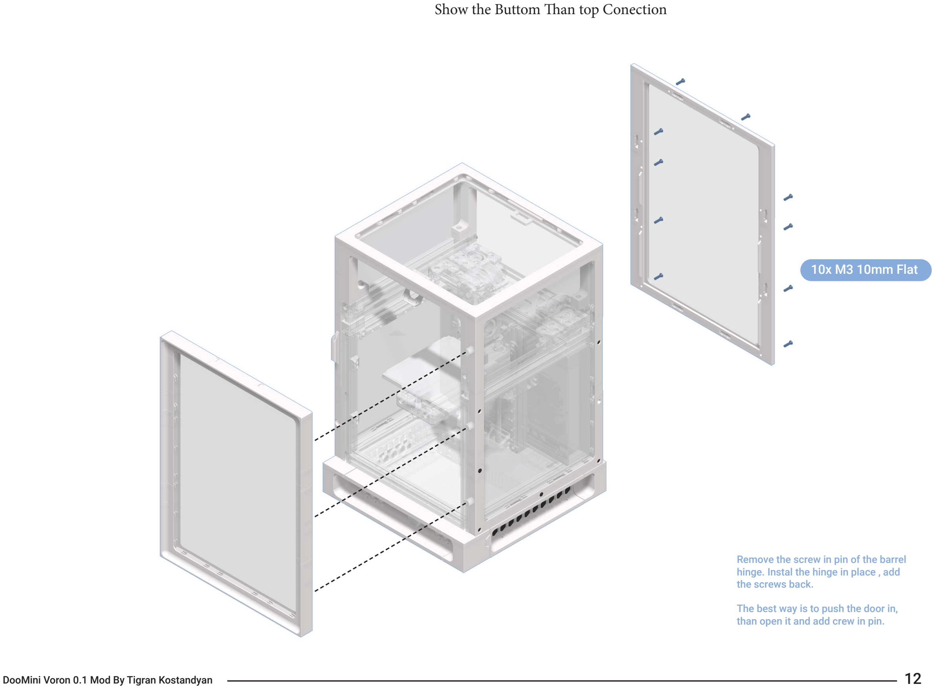
[picture p64: page 12]

DooMini Voron 0.1 Mod By Tigran Kostandyan | 12

### 10x M3 10mm Flat

Remove the screw in pin of the barrel hinge. Instal the hinge in place , add the screws back.

The best way is to push the door in, than open it and add crew in pin.

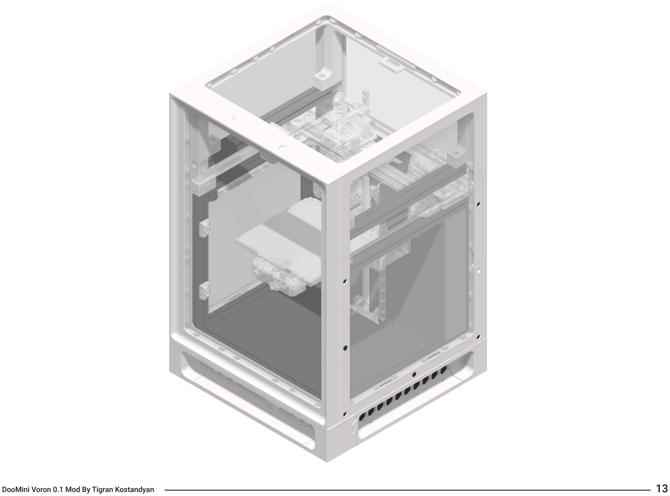
[picture p65: page 13]

DooMini Voron 0.1 Mod By Tigran Kostandyan | 13
