TigranDesigner/Voron-Mods/(threads)

Thread 1 (2022-04-13):

door parts A and H

ryangadz, 2022-04-13:
door parts A and H looks like they have inverted geometry. mostly printed okay except for the circular plug

TigranDesigner, 2022-04-13:
I will check them out, do you have a screenshot of the issue, that will help me find it and fix it.

TigranDesigner, 2022-04-13:
PS .. thanks for the feedback

ryangadz, 2022-04-13:
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
a quite a few are like this actually. sometimes they print fine but in this case the hole was plugged
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

TigranDesigner, 2022-04-13:
Thank you. I will fix it up tonight

ryangadz, 2022-04-13:
I'm using Cura. Actually, A prints fine, but B is a problem strange

TigranDesigner, 2022-04-13:
there are a few that Github shows bad but they print fine ... Regardless I will check B after work.

TigranDesigner, 2022-04-15:
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
Fixed

Closed 2022-07-09.
