TigranDesigner/Voron-Mods/(commit log)

2022-02-13 Create Camera Holder .stl
    [Camera Holder .stl]
2022-02-14 Create 1X Back Panel.dxf
    [1X Back Panel.dxf]
2022-02-14 Create 1X Base Panel.dxf
    [1X Base Panel.dxf]
2022-02-14 Create 2X Door Panel.dxf
    [2X Door Panel.dxf]
2022-02-14 Create 2X Top Panel.dxf
    [2X Top Panel.dxf]
2022-02-14 Create 4X Side Panel.dxf
    [4X Side Panel.dxf]
2022-02-14 Create 3D printed Interlock X28.stl
    [3D printed Interlock X28.stl]
2022-02-14 Create Base Leg Back L (Needs Support) .stl
    [Base Leg Back L (Needs Support) .stl]
2022-02-14 Create Base Leg Back R (Needs Support) .stl
    [Base Leg Back R (Needs Support) .stl]
2022-02-14 Create Base Leg Front L.stl
    [Base Leg Front L.stl]
2022-02-14 Create Base Leg Front R.stl
    [Base Leg Front R.stl]
2022-02-14 Create Base Mesh Front X2.stl
    [Base Mesh Front X2.stl]
2022-02-14 Create Base Mesh Side A X2.stl
    [Base Mesh Side A X2.stl]
2022-02-14 Create Base Mesh Side B X2.stl
    [Base Mesh Side B X2.stl]
2022-02-14 Create Base Panel BAck.stl
    [Base Panel BAck.stl]
2022-02-14 Create Base Panel Front .stl
2022-02-14 Create Base Panel Front Knob.stl
    [Base Panel Front Knob.stl]
2022-02-14 Create Base Panel Front Screen Front .stl
    [Base Panel Front Screen Front .stl]
2022-02-14 Create Base Panel Front Screen Spacer.stl
    [Base Panel Front Screen Spacer.stl]
2022-02-14 Create Base Panel Left .stl
2022-02-14 Create Base Panel Right .stl
2022-02-14 Create Door A.stl
    [Door A.stl]
2022-02-14 Create Door B.stl
    [Door B.stl]
2022-02-14 Create Door C X2 .stl
    [Door C X2 .stl]
2022-02-14 Create Door E.stl
    [Door E.stl]
2022-02-14 Create Door F.stl
    [Door F.stl]
2022-02-14 Create Door G.stl
    [Door G.stl]
2022-02-14 Create Door H.stl
    [Door H.stl]
2022-02-14 Create Left A.stl
    [Left A.stl]
2022-02-14 Create Left B.stl
    [Left B.stl]
2022-02-14 Create Left C.stl
    [Left C.stl]
2022-02-14 Create Left D.stl
    [Left D.stl]
2022-02-14 Create Left E.stl
    [Left E.stl]
2022-02-14 Create Right A.stl
    [Right A.stl]
2022-02-14 Create Right B.stl
    [Right B.stl]
2022-02-14 Create Right C.stl
    [Right C.stl]
2022-02-14 Create Right D.stl
    [Right D.stl]
2022-02-14 Create Right E.stl
    [Right E.stl]
2022-02-14 Create Top A.stl
    [Top A.stl]
2022-02-14 Create Top B.stl
    [Top B.stl]
2022-02-14 Create Top C.stl
    [Top C.stl]
2022-02-14 Create Top Camera Holder.stl
    [Top Camera Holder.stl]
2022-02-14 Create Top D.stl
    [Top D.stl]
2022-02-14 Create Top E.stl
    [Top E.stl]
2022-02-14 Create Top F.stl
    [Top F.stl]
2022-02-14 Create Top G X2.stl
    [Top G X2.stl]
2022-02-14 Create Back A.stl
    [Back A.stl]
2022-02-14 Create Back B.stl
    [Back B.stl]
2022-02-14 Create Back C.stl
    [Back C.stl]
2022-02-14 Create Back D.stl
    [Back D.stl]
2022-02-14 Create Back E.stl
    [Back E.stl]
2022-02-14 Create Back F.stl
    [Back F.stl]
2022-02-14 Create Back G.stl
    [Back G.stl]
2022-02-14 Create Back H.stl
    [Back H.stl]
2022-02-16 Create 1X Back Panel Beta1.dxf
    [1X Back Panel Beta1.dxf]
2022-02-16 Create 1X Base Panel Beta1.dxf
    [1X Base Panel Beta1.dxf]
2022-02-16 Create 2X Door Panel Beta1.dxf
    [2X Door Panel Beta1.dxf]
2022-02-16 Create Back G Beta1.stl
    [Back G Beta1.stl]
2022-02-16 Create Back H Beta1.stl
    [Back H Beta1.stl]
2022-02-16 Create Base Leg Back L (Needs Support) Beta1.stl
    [Base Leg Back L (Needs Support) Beta1.stl]
2022-02-16 Create Base Leg Back R (Needs Support) Beta1.stl
    [Base Leg Back R (Needs Support) Beta1.stl]
2022-02-16 Create Base Leg Front L Beta1.stl
    [Base Leg Front L Beta1.stl]
2022-02-16 Create Base Leg Front R Beta1.stl
    [Base Leg Front R Beta1.stl]
2022-02-16 Create Base Mesh Front X2 Beta1.stl
    [Base Mesh Front X2 Beta1.stl]
2022-02-16 Create Base Mesh Side A X2 Beta1.stl
    [Base Mesh Side A X2 Beta1.stl]
2022-02-16 Create Base Mesh Side B X2 Beta1.stl
    [Base Mesh Side B X2 Beta1.stl]
2022-02-16 Create Base Panel BAck Beta1.stl
    [Base Panel BAck Beta1.stl]
2022-02-16 Adding Betta
    [2X Top Panel Beta1.dxf, 3D printed Interlock X28 Beta1.stl, 4X Side Pane Beta1l.dxf, Back A Beta1.stl, Back B Beta1.stl, Back C Beta1.stl, Back D Beta1.stl, Back E Beta1.stl]
2022-02-20 Fixed Leg
    [Base Leg Back L (Needs Support) Beta1.stl, Base Leg Back L (Needs Support) Beta2.stl, Base Leg Back R (Needs Support) Beta1.stl, Base Leg Back R (Needs Support) Beta2.stl]
2022-03-01 Wrong Orientation
    [Base Panel Front Screen Front Beta 2 .stl, Base Panel Front Screen Front Beta1.stl]
2022-03-02 Back Panel Fixed
    [Base Panel BAck Beta1.stl, Base Panel Back Beta 2 Option B Recessed (Needs Support).stl, Base Panel Back Beta 2.stl]
2022-03-02 Small Back Tab Fix
    [Base Panel Back Beta 2 Option B Recessed (Needs Support).stl, Base Panel Back Beta 2.stl, Base Panel Back Beta 3 Option B Recessed (Needs Support).stl, Base Panel Back Beta 3.stl]
2022-03-07 note so people don't print from CAD
2022-03-14 More Ventilation
    [1X Back Panel Beta 2.dxf]
2022-03-18 Pim comments
    [Left C Beta 2.stl, Left C Beta1.stl, Left D Beta 2.stl, Left D Beta1.stl, Left E Beta 2.stl, Left E Beta1.stl, Right C Beta 2.stl, Right C Beta1.stl]
2022-04-15 Create Door B Beta2.stl
    [Door B Beta2.stl]
2022-04-15 Update Door B Beta2.stl
    [Door B Beta2.stl]
2022-06-10 Fixed Non-manifold Edges
    [Base Panel Front Beta2.stl]
2022-06-12 non manifold edge fix
    [Base Panel Left Beta2.stl, Base Panel Right Beta2.stl]
2022-06-12 DooMini Hinge
    [Hinge.stl]
2022-08-16 Bug Fix
    [Door H Beta1.stl, Door H Beta2.stl]
2022-09-06 Updated Cad
